QuyIOT/embedded-system-project/hardware_design/RFID_DOOR_LOCK/Project Outputs for RFID_DOOR_LOCK/BOM_RFID_DOOR_LOCK.xlsx

Line # | Name | Description | Designator | Quantity | TargetPrice | Manufacturer 1 | Manufacturer Part Number 1 | Manufacturer Lifecycle 1 | Supplier 1 | Supplier Part Number 1 | Supplier Unit Price 1 | Supplier Subtotal 1
 | 0.1uF | Cap np W0.4 | C1, C2, C3, C8, C11, C12 | 6 | 0 | Kyocera AVX | 08055C104KAT2A | Volume Production | Newark | 27C8438 | 0.1 | 0.6
 | 100uF |  | C4 | 1 | 0 | Panasonic | EEE-FT1V101AP | Volume Production | Digikey | PCE5016CT-ND | 0.64 | 0.64
 | 220uF |  | C5 | 1 | 0 | Panasonic | EEE-FP1V221AP | Volume Production | Digikey | PCE4444CT-ND | 1 | 1
 | 10uF | Cap np W0.4 | C6, C7 | 2 | 0 | Murata | GRM21BR61C106KE15L | Volume Production | Digikey | 490-3886-1-ND | 0.14 | 0.28
 | JP2 | WR-PHD 2.54 mm Angled Socket Header | C9 | 1 | 0 | OEM | none | Manual Solution | Thegioiic
 | JP4 | WR-PHD 2.54 mm Angled Socket Header | C10 | 1 | 0 | OEM | none | Manual Solution | Thegioiic
 | LED GREEN |  | D1 | 1 | 0 | Vishay | TLLG4401 | Volume Production | Newark | 78Y9594 | 0.526 | 0.526
 | DIODE | Diode | D2 | 1 | 0 | ON Semiconductor / Fairchild | LL4148 | Volume Production | Digikey | LL4148FSDKR-ND | 0.1 | 0.1
 | DIODE SCHOTTKY | Schottky Diode | D3, D5 | 2 | 0 | Multicomp | SS34 | Volume Production | Newark | 90R9191 | 0.495 | 0.99
 | LED RED |  | D4 | 1 | 0 | Wurth Electronics | 151031SS04000 | Volume Production | Digikey | 732-5005-ND | 0.16 | 0.16
 | Diode zener | Diode | D6 | 1 | 0 | OEM | ZMM3V3 | Manual Solution | Thegioiic
 | 47uH |  | L_N1 | 1 | 0 | Wurth Electronics | 744770147 | Volume Production | Digikey | 732-1231-1-ND | 2.16 | 2.16
 | DOMINO |  | LOCK, Power Supply | 2 | 0 | Kefa-Maixu Electronics | none | Manual Solution | Thegioiic
 | ESP32-WROOM-32D | ESP32 | M1 | 1 | 0 | Espressif Systems | ESP32-WROOM-32D (8MB) | Unknown | Thegioiic
 | 2SC1815 | NPN 600mW, ECB | Q1, Q2 | 2 | 0 | Generic | 2SC1815HFJYT-100 | Unknown | Thegioiic
 | 10k | Resistor 1/4W | R1, R2, R4, R9, R12, R13, R15, R16 | 8 | 0 | Yageo | RC0805FR-0710KL | Volume Production | Digikey | 311-10.0KCRCT-ND | 0.016 | 0.16
 | 1k | Resistor 1/4W | R3, R6, R7, R10 | 4 | 0 | Yageo | RC0805FR-071KL | Volume Production | Digikey | 311-1.00KCRCT-ND | 0.012 | 0.12
 | 330 | Resistor 1/4W | R5, R11, R14 | 3 | 0 | Panasonic | ERJ-6ENF3303V | Volume Production | Digikey | P330KCCT-ND | 0.11 | 0.33
 | 22k | Resistor 1/4W | R8 | 1 | 0 | OEM | none | Manual Solution | Thegioiic
 | RFID-RC522 | RFID-RC522 | RFID1 | 1 | 0 | OEM | none | Manual Solution | Thegioiic
 | Relay 10A/5V | Relay SPDT,10A - 12VDC 5 Pin | RL1 | 1 | 0 | Ningbo Forward Relay | SRD-05VDC-SL-C | Volume Production | Thegioiic
 | SW | Switch button 4 pin | SW1, SW2 | 2 | 0 | TE Connectivity | 1825910-2 | Volume Production | Digikey | 450-1649-ND | 0.15 | 0.3
 | BUZZER | Buzzer | U1 | 1 | 0 | TDK | PS1440P02BT | Volume Production | Digikey | 445-5242-1-ND | 0.7 | 0.7
 | LM2596S | SIMPLE SWITCHER; 3A Step-Down Voltage Regulator | U2 | 1 | 0 | TI National Semiconductor | LM2596SX-ADJ/NOPB | Volume Production | Digikey | 296-35399-6-ND | 5.76 | 5.76
 | AMS1117 |  | U3 | 1 | 0 | UMW(Youtai Semiconductor Co., Ltd.) | AMS1117-3.3 | Unknown | Digikey | 4518-AMS1117-3.3CT-ND | 0.68 | 0.68
 | PC817 | Single Opto | U4 | 1 | 0 | Sharp | PC817X3NSZ1B | Volume Production | Thegioiic
 | 24LC256 | 256KBit I2C CMOS Serial EEPROM | U5 | 1 | 0 | Microchip | 24LC256-I/SN | Volume Production | Digikey | 24LC256-I/SN-ND | 1.11 | 1.11
