QuyIOT/embedded-system-project/(list of files, drawings)

Other design files:
hardware_design/RFID_DOOR_LOCK/01.Index.SchDoc
hardware_design/RFID_DOOR_LOCK/02.BlockDiagram.SchDoc
hardware_design/RFID_DOOR_LOCK/03.PowerDiagram.SchDoc
hardware_design/RFID_DOOR_LOCK/04.Schematic.SchDoc
hardware_design/RFID_DOOR_LOCK/RFID_DOOR_LOCK.PrjPcb
