QuyIOT/embedded-system-project/software_design/RFID_DOOR_LOCK/common/input/input.h

#ifndef INPUT_H 
#define INPUT_H 
#include "esp_err.h" 
#include "hal/gpio_types.h" 
typedef void (*input_callback_t) (int); 
typedef enum{ 
	LO_TO_HI = 1, 
	HI_TO_LO = 2, 
	ANY_EDLE = 3 
} interrupt_type_edle_t; 
void input_io_create(gpio_num_t gpio_num, interrupt_type_edle_t type); 
void input_io_get_level(gpio_num_t gpio_num); 
void input_set_callback(void * cb); 
#endif
